kuellenberg/DP83848C-EvalBoard/STM32F407-MII-Pinout.png

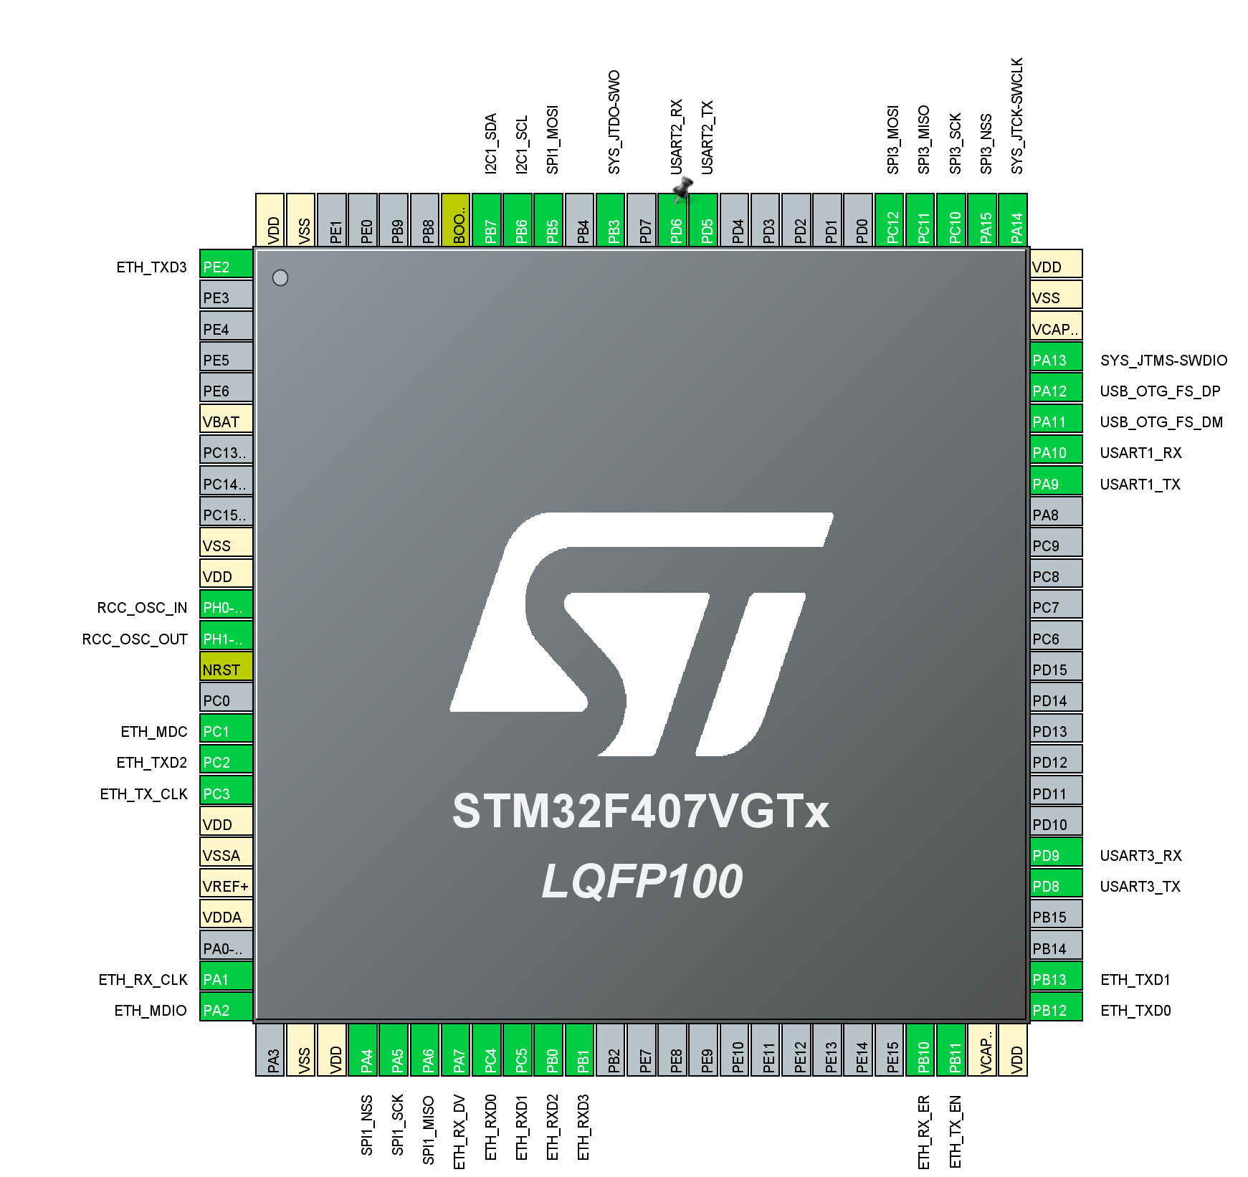
STM32F407-MII-Pinout.png
