kuellenberg/DP83848C-EvalBoard/DP83848C-EvalBoard.kicad_pcb

## KiCad design DP83848C-EvalBoard.kicad_pcb (2021-02-22)

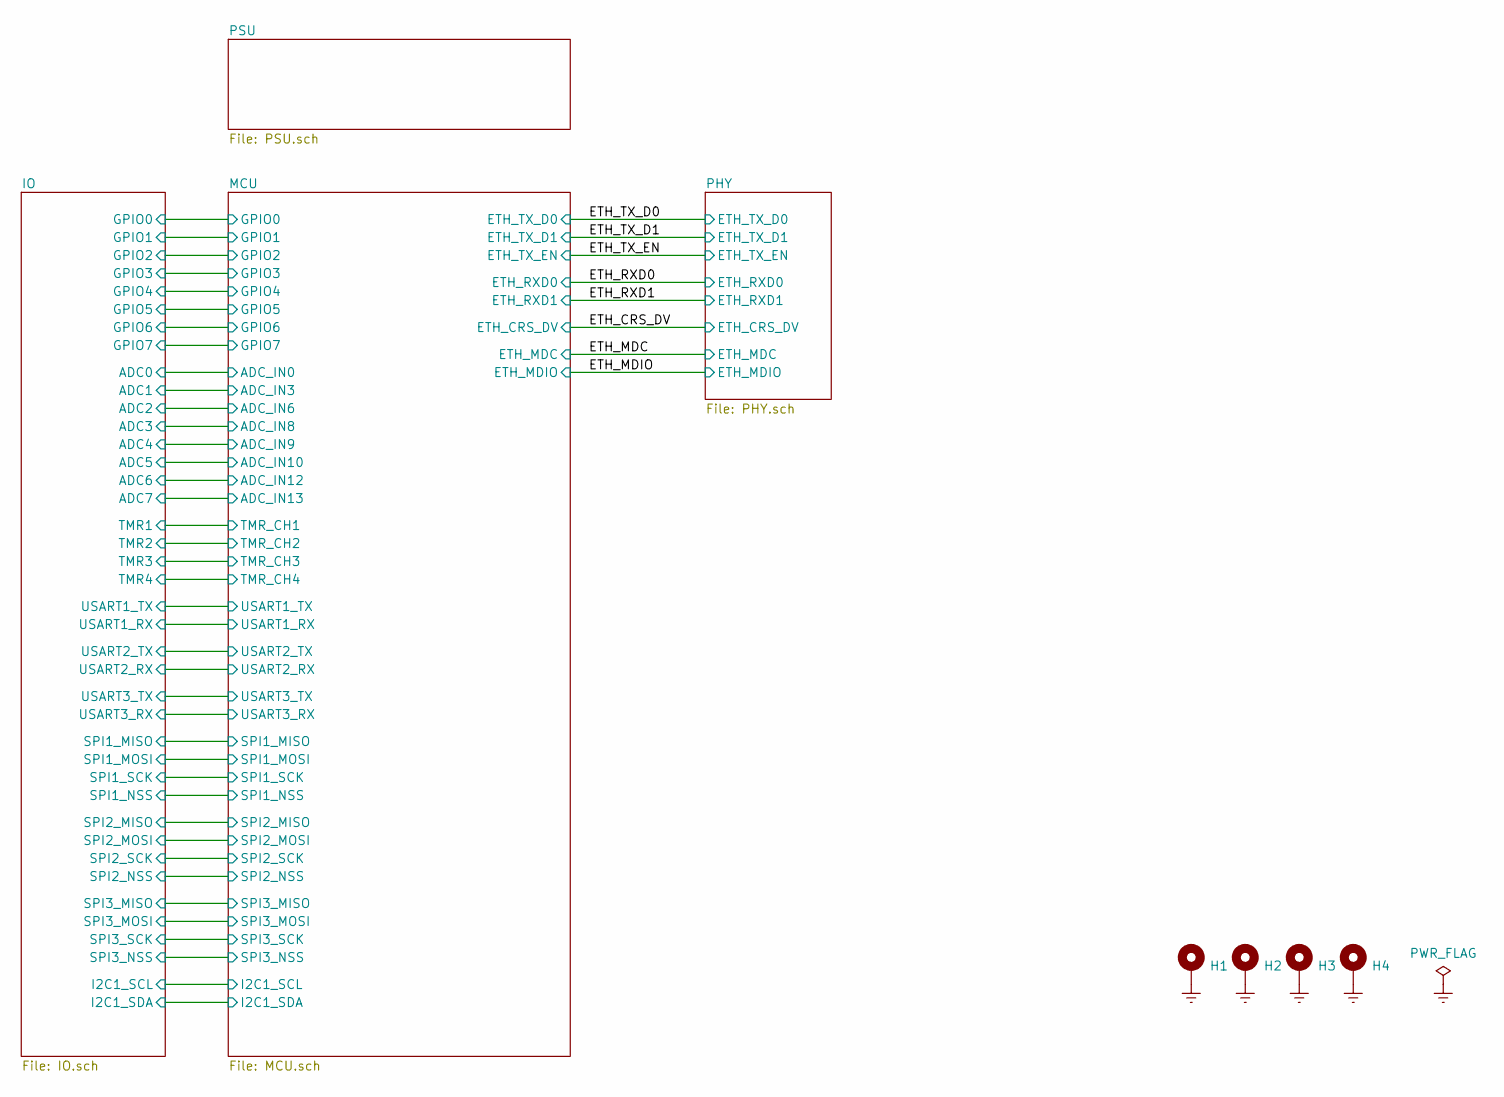
[picture p2: schematic DP83848C-EvalBoard.sch, DP83848C Eval Board]

Parts:
H1, H2, H3, H4: MountingHole_Pad; MountingHole_3.2mm_M3_Pad_Via

Connections:
Earth: H1.1, H2.1, H3.1, H4.1; also elsewhere on the board

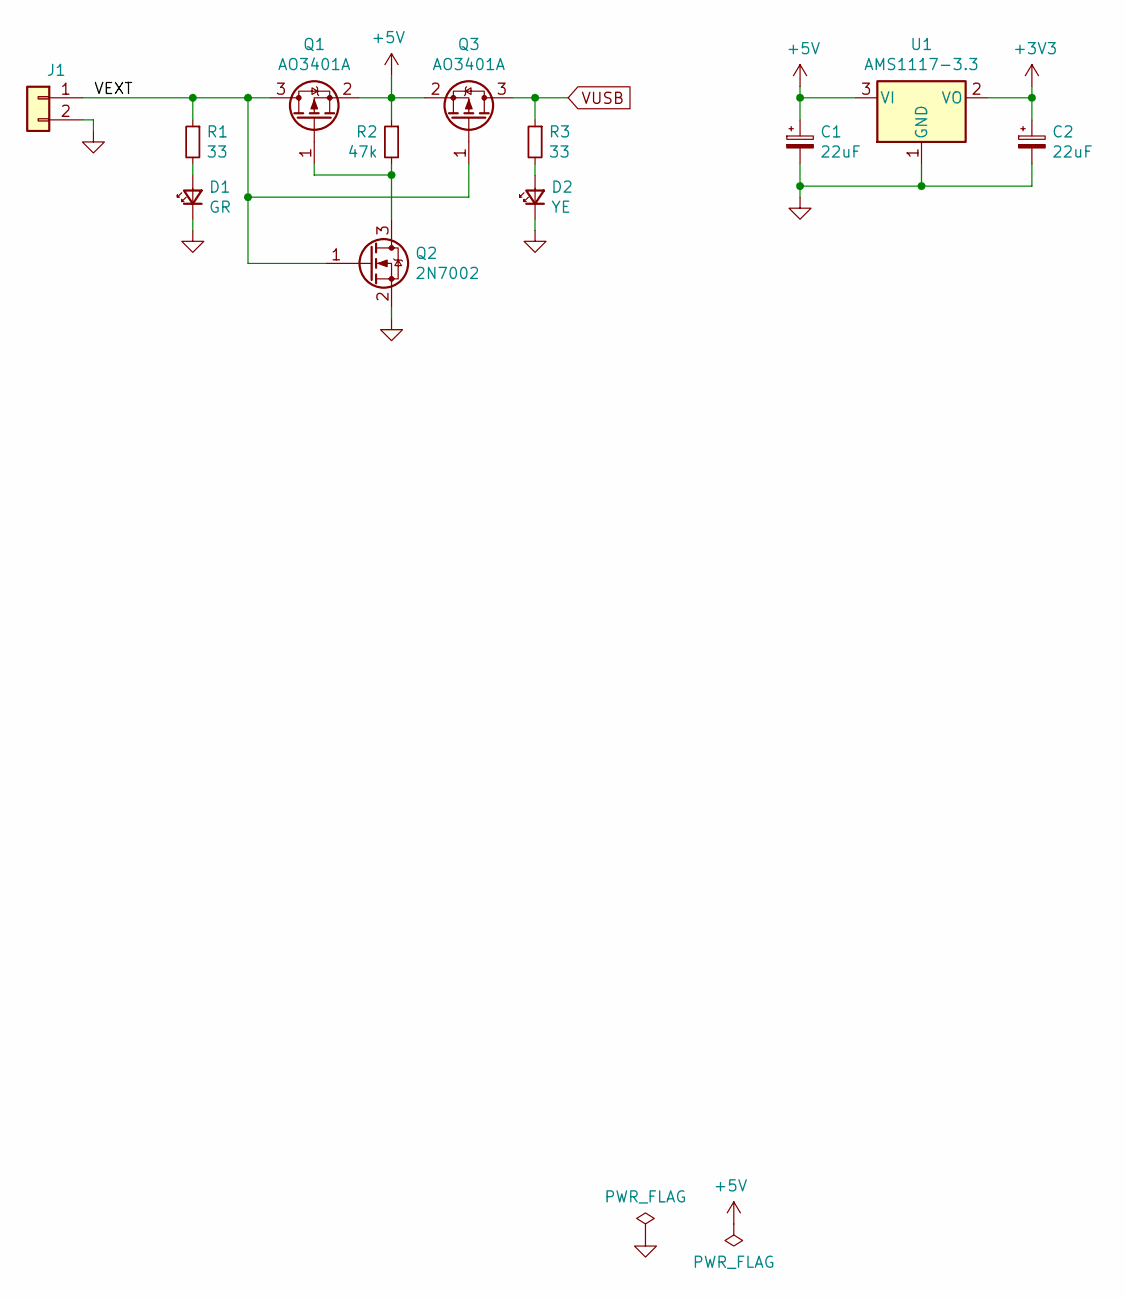
[picture p3: schematic PSU.sch]

Parts:
C1, C2: 22uF; CP_EIA-3528-15_AVX-H; LCSC C8020
D1: GR; LED_0603_1608Metric; LCSC C72043
D2: YE; LED_0603_1608Metric; LCSC C72038
J1: Conn_01x02; Molex_022112022; Mouser 538-22-11-2022
Q1, Q3: AO3401A; SOT-23; LCSC C15127
Q2: 2N7002; SOT-23; LCSC C8545
R1, R3: 33; R_0402_1005Metric; LCSC C25105
R2: 47k; R_0402_1005Metric; LCSC C25792
U1: AMS1117-3.3; SOT-223-3_TabPin2; LCSC C6186

Connections:
+3V3: C2.1, U1.2 (VO); also elsewhere on the board
+5V: C1.1, Q1.2 (S), Q3.2 (S), R2.1, U1.3 (VI)
/PSU/VEXT: J1.1, Q1.3 (D), Q2.1 (G), Q3.1 (G), R1.1
GND: C1.2, C2.2, D1.1 (K), D2.1 (K), J1.2, Q2.2 (S), U1.1 (GND); also elsewhere on the board
unnamed: D1.2 (A), R1.2
unnamed: D2.2 (A), R3.2
unnamed: Q1.1 (G), Q2.3 (D), R2.2
VUSB: Q3.3 (D), R3.1; also elsewhere on the board

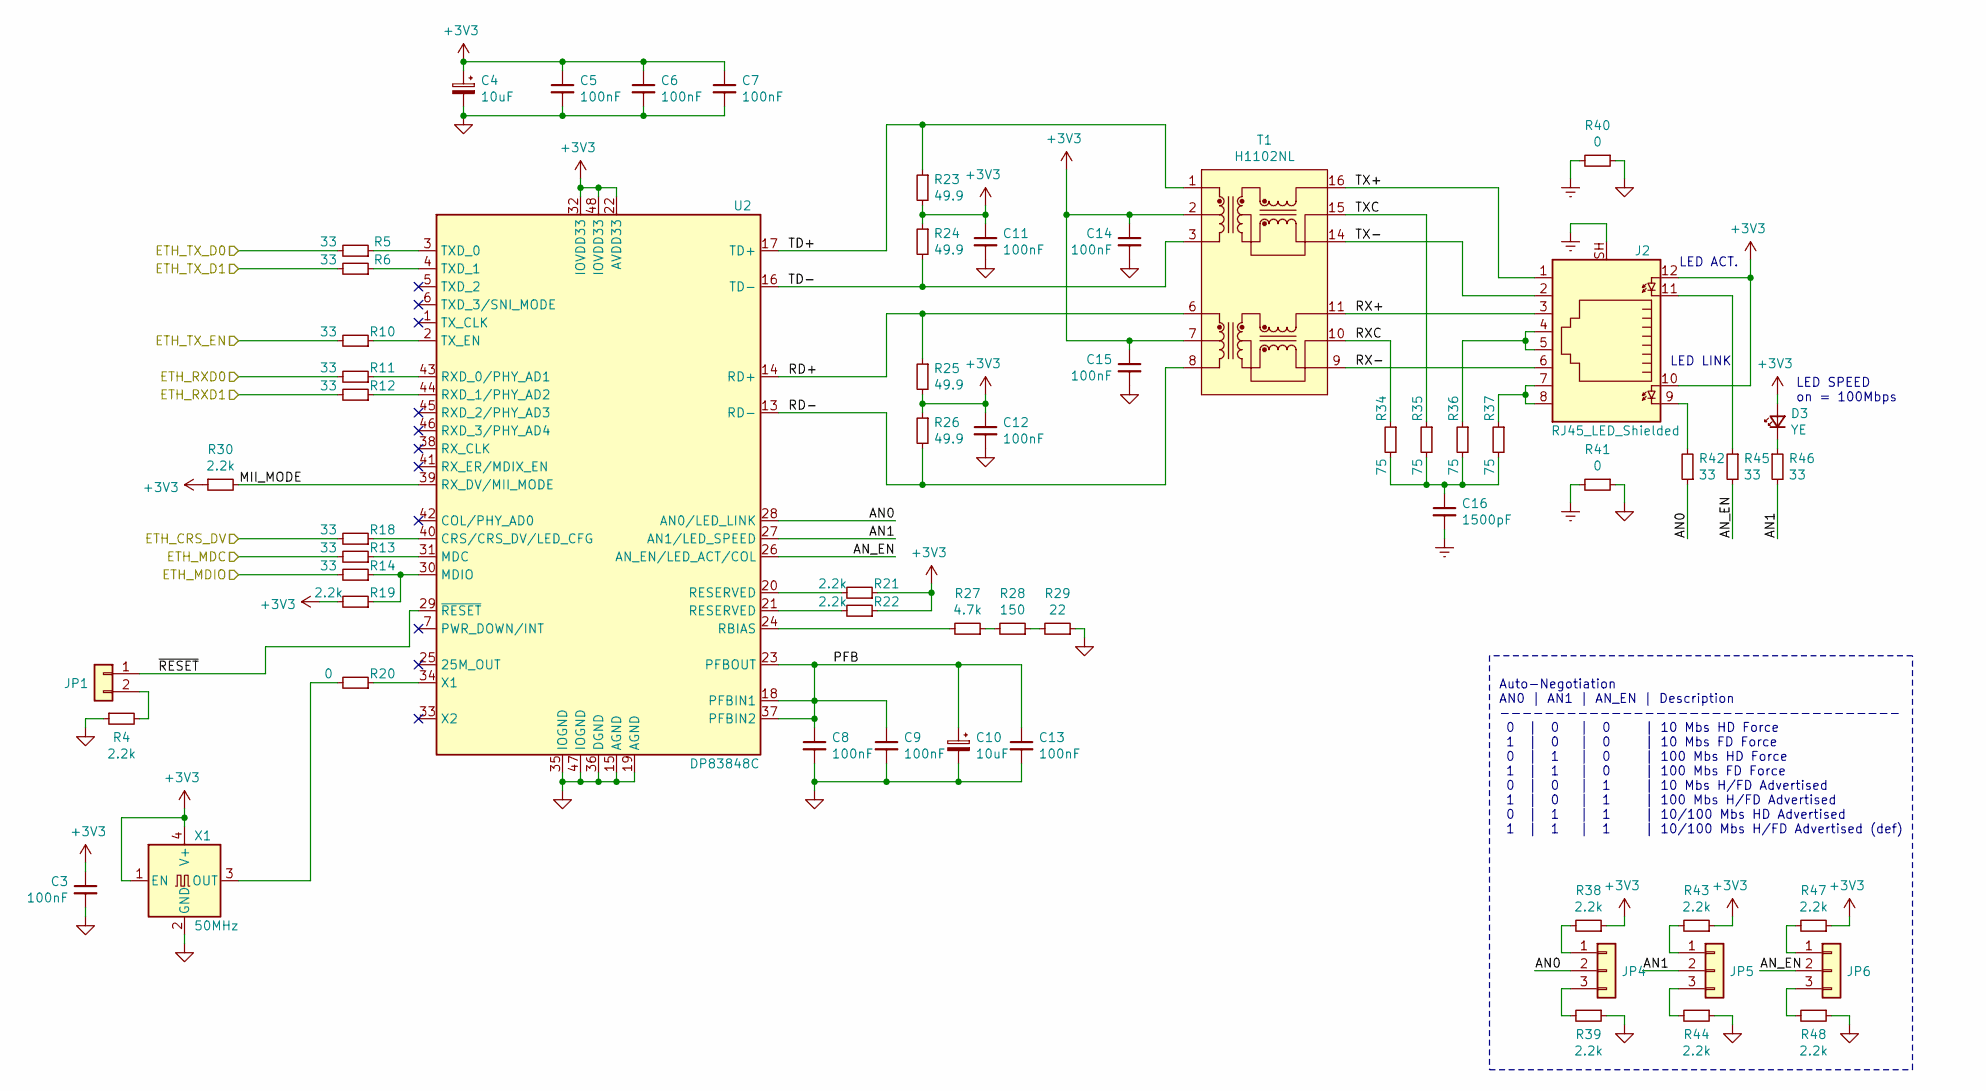
[picture p4: schematic PHY.sch, DP83848C Eval Board]

Parts:
C3, C5, C6, C7, C8, C9, C11, C12, C13, C14, C15: 100nF; C_0402_1005Metric; LCSC C1525
C4, C10: 10uF; CP_EIA-3216-18_Kemet-A; LCSC C7171
C16: 1500pF; C_0402_1005Metric; LCSC C23967
D3: YE; LED_0603_1608Metric; LCSC C72038
J2: RJ45_LED_Shielded; RJ45_Amphenol_RJHSE538X; Mouser 523-RJHSE-5381
JP1: Conn_01x02; PinHeader_1x02_P2.54mm_Vertical
JP4, JP5, JP6: Conn_01x03; PinHeader_1x03_P2.54mm_Vertical
R4, R19, R21, R22, R30, R38, R39, R43, R44, R47, R48: 2.2k; R_0402_1005Metric; LCSC C25879
R5, R6, R10, R11, R12, R13, R14, R18, R42, R45, R46: 33; R_0402_1005Metric; LCSC C25105
R20: 0; R_0402_1005Metric; LCSC C17168
R23, R24, R25, R26: 49.9; R_0402_1005Metric; LCSC C25120
R27: 4.7k; R_0402_1005Metric; LCSC C25900
R28: 150; R_0402_1005Metric; LCSC C25082
R29: 22; R_0402_1005Metric; LCSC C25092
R34, R35, R36, R37: 75; R_0402_1005Metric; LCSC C25133
R40, R41: 0; R_1206_3216Metric; LCSC C17888
T1: H1102NL; Transformer_Pulse_H1100NL; LCSC C18584
U2: DP83848C; LQFP-48_7x7mm_P0.5mm; LCSC C16688
X1: 50MHz; Oscillator_SMD_EuroQuartz_XO32-4Pin_3.2x2.5mm; LCSC C717684

Connections:
+3V3: C3.1, C4.1, C5.1, C6.1, C7.1, C11.1, C12.1, C14.1, C15.1, D3.2 (A), J2.10, J2.12, R19.2, R21.1, R22.1, R23.2, R24.1, R25.2, R26.1, R30.1, R38.1, R43.1, R47.1, T1.2, T1.7, U2.22 (AVDD33), U2.32 (IOVDD33), U2.48 (IOVDD33), X1.1 (EN), X1.4 (V+); also elsewhere on the board
/ETH_CRS_DV: R18.2; also elsewhere on the board
/ETH_MDC: R13.2; also elsewhere on the board
/ETH_MDIO: R14.2; also elsewhere on the board
/ETH_RXD0: R11.2; also elsewhere on the board
/ETH_RXD1: R12.2; also elsewhere on the board
/ETH_TX_D0: R5.2; also elsewhere on the board
/ETH_TX_D1: R6.2; also elsewhere on the board
/ETH_TX_EN: R10.2; also elsewhere on the board
/PHY/AN0: JP4.2, R42.1, U2.28 (AN0/LED_LINK)
/PHY/AN1: JP5.2, R46.2, U2.27 (AN1/LED_SPEED)
/PHY/AN_EN: JP6.2, R45.2, U2.26 (AN_EN/LED_ACT/COL)
/PHY/MII_MODE: R30.2, U2.39 (RX_DV/MII_MODE)
/PHY/PFB: C8.1, C9.1, C10.1, C13.1, U2.18 (PFBIN1), U2.23 (PFBOUT), U2.37 (PFBIN2)
/PHY/RD+: R25.1, T1.6, U2.14 (RD+)
/PHY/RD-: R26.2, T1.8, U2.13 (RD-)
/PHY/RX+: J2.3, T1.11
/PHY/RX-: J2.6, T1.9
/PHY/RXC: R34.1, T1.10
/PHY/TD+: R23.1, T1.1, U2.17 (TD+)
/PHY/TD-: R24.2, T1.3, U2.16 (TD-)
/PHY/TX+: J2.1, T1.16
/PHY/TX-: J2.2, T1.14
/PHY/TXC: R35.1, T1.15
/PHY/~RESET: JP1.1, U2.29 (~RESET~)
Earth: C16.2, J2.SH, R40.2, R41.2; also elsewhere on the board
GND: C3.2, C4.2, C5.2, C6.2, C7.2, C8.2, C9.2, C10.2, C11.2, C12.2, C13.2, C14.2, C15.2, R4.1, R29.1, R39.1, R40.1, R41.1, R44.1, R48.1, U2.15 (AGND), U2.19 (AGND), U2.35 (IOGND), U2.36 (DGND), U2.47 (IOGND), X1.2 (GND); also elsewhere on the board
unnamed: C16.1, R34.2, R35.2, R36.2, R37.2
unnamed: D3.1 (K), R46.1
unnamed: J2.4, J2.5, R36.1
unnamed: J2.7, J2.8, R37.1
unnamed: J2.9, R42.2
unnamed: J2.11, R45.1
unnamed: JP1.2, R4.2
unnamed: JP4.1, R38.2
unnamed: JP4.3, R39.2
unnamed: JP5.1, R43.2
unnamed: JP5.3, R44.2
unnamed: JP6.1, R47.2
unnamed: JP6.3, R48.2
unnamed: R5.1, U2.3 (TXD_0)
unnamed: R6.1, U2.4 (TXD_1)
unnamed: R10.1, U2.2 (TX_EN)
unnamed: R11.1, U2.43 (RXD_0/PHY_AD1)
unnamed: R12.1, U2.44 (RXD_1/PHY_AD2)
unnamed: R13.1, U2.31 (MDC)
unnamed: R14.1, R19.1, U2.30 (MDIO)
unnamed: R18.1, U2.40 (CRS/CRS_DV/LED_CFG)
unnamed: R20.1, U2.34 (X1)
unnamed: R20.2, X1.3 (OUT)
unnamed: R21.2, U2.20 (RESERVED)
unnamed: R22.2, U2.21 (RESERVED)
unnamed: R27.1, R28.2
unnamed: R27.2, U2.24 (RBIAS)
unnamed: R28.1, R29.2

Notes on the sheet:
Auto-Negotiation AN0 | AN1 | AN_EN | Description ------------------------------------ 0 | 0 | 0 | 10 Mbs HD Force 1 | 0 | 0 | 10 Mbs FD Force 0 | 1 | 0 | 100 Mbs HD Force 1 | 1 | 0 | 100 Mbs FD Force 0 | 0 | 1 | 10 Mbs H/FD Advertised 1 | 0 | 1 | 100 Mbs H/FD Advertised 0 | 1 | 1 | 10/100 Mbs HD Ad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
LED ACT.
LED LINK
LED SPEED on = 100Mbps

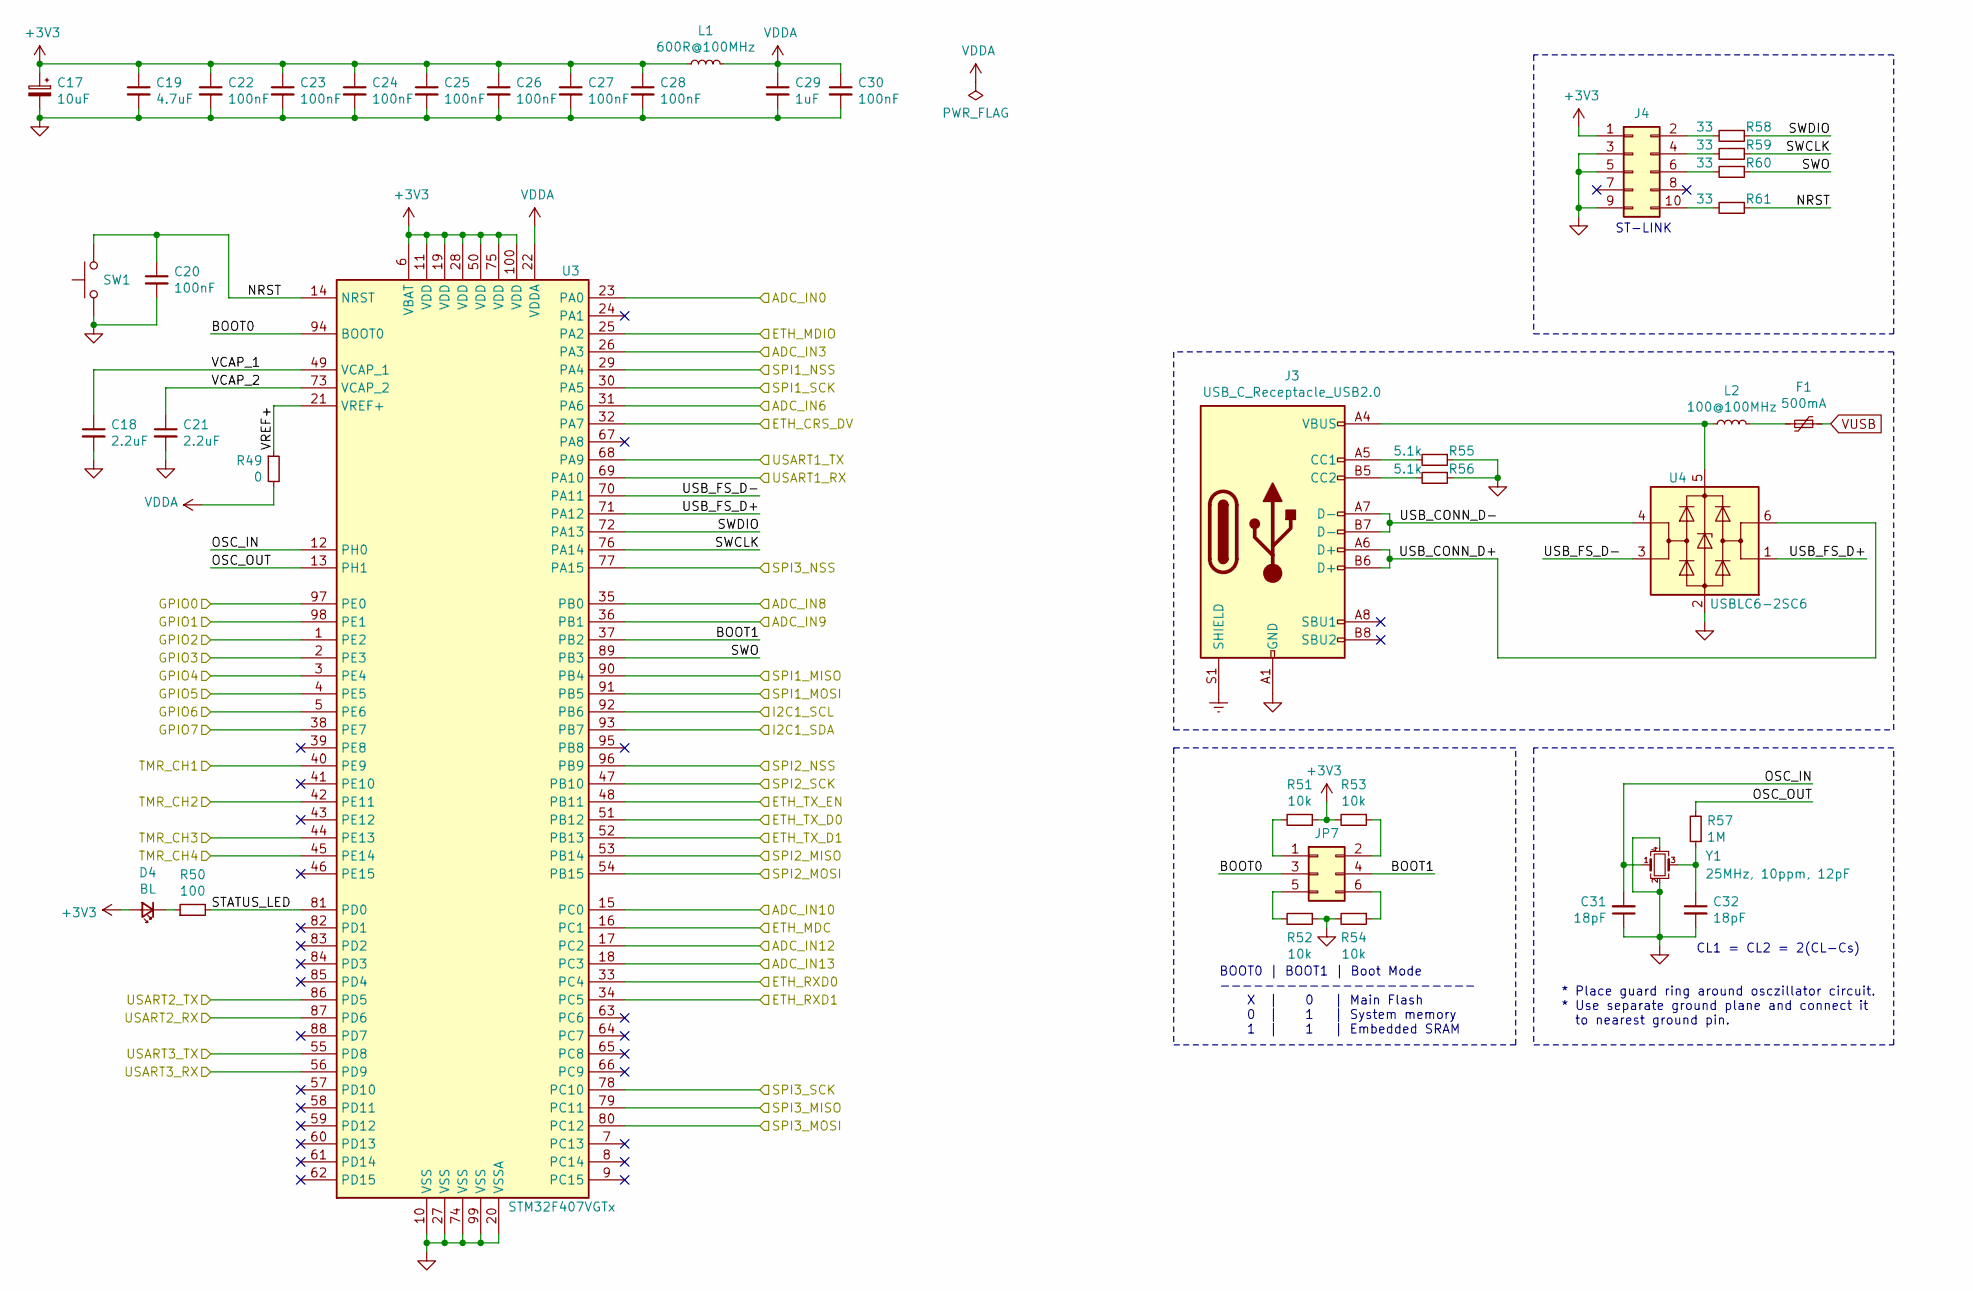
[picture p5: schematic MCU.sch]

Parts:
C17: 10uF; CP_EIA-3216-18_Kemet-A; LCSC C7171
C18, C21: 2.2uF; C_0603_1608Metric; LCSC C23630
C19: 4.7uF; C_0402_1005Metric; LCSC C23733
C20, C22, C23, C24, C25, C26, C27, C28, C30: 100nF; C_0402_1005Metric; LCSC C1525
C29: 1uF; C_0402_1005Metric; LCSC C52923
C31, C32: 18pF; C_0402_1005Metric; LCSC C1549
D4: BL; LED_0603_1608Metric; LCSC C72041
F1: 500mA; Fuse_1812_4532Metric_Castellated; Mouser 576-1812L050/60MR
J3: USB_C_Receptacle_USB2.0; DX07S016JA3R1500; Mouser 656-DX07S016JA3R1500
J4: Conn_02x05_Odd_Even; PinHeader_2x05_P2.54mm_Vertical
JP7: Conn_02x03_Odd_Even; PinHeader_2x03_P2.54mm_Vertical
L1: 600R@100MHz; L_0805_2012Metric; LCSC C1002
L2: 100@100MHz; L_0805_2012Metric; LCSC C1015
R49: 0; R_0402_1005Metric; LCSC C17168
R50: 100; R_0402_1005Metric; LCSC C25076
R51, R52, R53, R54: 10k; R_0402_1005Metric; LCSC C25744
R55, R56: 5.1k; R_0402_1005Metric; LCSC C25905
R57: 1M; R_0402_1005Metric; LCSC C26083
R58, R59, R60, R61: 33; R_0402_1005Metric; LCSC C25105
SW1: SW_Push; SW_PUSH_6mm; Mouser 611-PTS645SK432
U3: STM32F407VGTx; LQFP-100_14x14mm_P0.5mm; LCSC C28730
U4: USBLC6-2SC6; SOT-23-6; LCSC C7519
Y1: 25MHz, 10ppm, 12pF; Crystal_SMD_3225-4Pin_3.2x2.5mm; LCSC C9006

Connections:
+3V3: C17.1, C19.1, C22.1, C23.1, C24.1, C25.1, C26.1, C27.1, C28.1, D4.2 (A), J4.1, L1.1, R51.1, R53.2, U3.6 (VBAT), U3.11 (VDD), U3.19 (VDD), U3.28 (VDD), U3.50 (VDD), U3.75 (VDD), U3.100 (VDD); also elsewhere on the board
/ETH_CRS_DV: U3.32 (PA7); also elsewhere on the board
/ETH_MDC: U3.16 (PC1); also elsewhere on the board
/ETH_MDIO: U3.25 (PA2); also elsewhere on the board
/ETH_RXD0: U3.33 (PC4); also elsewhere on the board
/ETH_RXD1: U3.34 (PC5); also elsewhere on the board
/ETH_TX_D0: U3.51 (PB12); also elsewhere on the board
/ETH_TX_D1: U3.52 (PB13); also elsewhere on the board
/ETH_TX_EN: U3.48 (PB11); also elsewhere on the board
/IO/ADC0: U3.23 (PA0); also elsewhere on the board
/IO/ADC1: U3.26 (PA3); also elsewhere on the board
/IO/ADC2: U3.31 (PA6); also elsewhere on the board
/IO/ADC3: U3.35 (PB0); also elsewhere on the board
/IO/ADC4: U3.36 (PB1); also elsewhere on the board
/IO/ADC5: U3.15 (PC0); also elsewhere on the board
/IO/ADC6: U3.17 (PC2); also elsewhere on the board
/IO/ADC7: U3.18 (PC3); also elsewhere on the board
/IO/GPIO0: U3.97 (PE0); also elsewhere on the board
/IO/GPIO1: U3.98 (PE1); also elsewhere on the board
/IO/GPIO2: U3.1 (PE2); also elsewhere on the board
/IO/GPIO3: U3.2 (PE3); also elsewhere on the board
/IO/GPIO4: U3.3 (PE4); also elsewhere on the board
/IO/GPIO5: U3.4 (PE5); also elsewhere on the board
/IO/GPIO6: U3.5 (PE6); also elsewhere on the board
/IO/GPIO7: U3.38 (PE7); also elsewhere on the board
/IO/I2C1_SCL: U3.92 (PB6); also elsewhere on the board
/IO/I2C1_SDA: U3.93 (PB7); also elsewhere on the board
/IO/SPI1_MISO: U3.90 (PB4); also elsewhere on the board
/IO/SPI1_MOSI: U3.91 (PB5); also elsewhere on the board
/IO/SPI1_NSS: U3.29 (PA4); also elsewhere on the board
/IO/SPI1_SCK: U3.30 (PA5); also elsewhere on the board
/IO/SPI2_MISO: U3.53 (PB14); also elsewhere on the board
/IO/SPI2_MOSI: U3.54 (PB15); also elsewhere on the board
/IO/SPI2_NSS: U3.96 (PB9); also elsewhere on the board
/IO/SPI2_SCK: U3.47 (PB10); also elsewhere on the board
/IO/SPI3_MISO: U3.79 (PC11); also elsewhere on the board
/IO/SPI3_MOSI: U3.80 (PC12); also elsewhere on the board
/IO/SPI3_NSS: U3.77 (PA15); also elsewhere on the board
/IO/SPI3_SCK: U3.78 (PC10); also elsewhere on the board
/IO/TMR1: U3.40 (PE9); also elsewhere on the board
/IO/TMR2: U3.42 (PE11); also elsewhere on the board
/IO/TMR3: U3.44 (PE13); also elsewhere on the board
/IO/TMR4: U3.45 (PE14); also elsewhere on the board
/IO/USART1_RX: U3.69 (PA10); also elsewhere on the board
/IO/USART1_TX: U3.68 (PA9); also elsewhere on the board
/IO/USART2_RX: U3.87 (PD6); also elsewhere on the board
/IO/USART2_TX: U3.86 (PD5); also elsewhere on the board
/IO/USART3_RX: U3.56 (PD9); also elsewhere on the board
/IO/USART3_TX: U3.55 (PD8); also elsewhere on the board
/MCU/BOOT0: JP7.3, U3.94 (BOOT0)
/MCU/BOOT1: JP7.4, U3.37 (PB2)
/MCU/NRST: C20.1, R61.1, SW1.1, U3.14 (NRST)
/MCU/OSC_IN: C31.2, U3.12 (PH0), Y1.1
/MCU/OSC_OUT: R57.2, U3.13 (PH1)
/MCU/STATUS_LED: R50.2, U3.81 (PD0)
/MCU/SWCLK: R59.1, U3.76 (PA14)
/MCU/SWDIO: R58.1, U3.72 (PA13)
/MCU/SWO: R60.1, U3.89 (PB3)
/MCU/USB_CONN_D+: J3.A6 (D+), J3.B6 (D+), U4.6 (I/O1)
/MCU/USB_CONN_D-: J3.A7 (D-), J3.B7 (D-), U4.4 (I/O2)
/MCU/USB_FS_D+: U3.71 (PA12), U4.1 (I/O1)
/MCU/USB_FS_D-: U3.70 (PA11), U4.3 (I/O2)
/MCU/VCAP_1: C18.1, U3.49 (VCAP_1)
/MCU/VCAP_2: C21.1, U3.73 (VCAP_2)
/MCU/VREF+: R49.1, U3.21 (VREF+)
Earth: J3.S1 (SHIELD); also elsewhere on the board
GND: C17.2, C18.2, C19.2, C20.2, C21.2, C22.2, C23.2, C24.2, C25.2, C26.2, C27.2, C28.2, C29.2, C30.2, C31.1, C32.2, J3.A1 (GND), J3.A12 (GND), J3.B1 (GND), J3.B12 (GND), J4.3, J4.5, J4.9, R52.1, R54.2, R55.1, R56.1, SW1.2, U3.10 (VSS), U3.20 (VSSA), U3.27 (VSS), U3.74 (VSS), U3.99 (VSS), U4.2 (GND), Y1.2, Y1.4; also elsewhere on the board
unnamed: C32.1, R57.1, Y1.3
unnamed: D4.1 (K), R50.1
unnamed: F1.2, L2.2
unnamed: J3.A4 (VBUS), J3.A9 (VBUS), J3.B4 (VBUS), J3.B9 (VBUS), L2.1, U4.5 (VBUS)
unnamed: J3.A5 (CC1), R55.2
unnamed: J3.B5 (CC2), R56.2
unnamed: J4.2, R58.2
unnamed: J4.4, R59.2
unnamed: J4.6, R60.2
unnamed: J4.10, R61.2
unnamed: JP7.1, R51.2
unnamed: JP7.2, R53.1
unnamed: JP7.5, R52.2
unnamed: JP7.6, R54.1
VDDA: C29.1, C30.1, L1.2, R49.2, U3.22 (VDDA)
VUSB: F1.1; also elsewhere on the board

Notes on the sheet:
BOOT0 | BOOT1 | Boot Mode ----------------------- X | 0 | Main Flash 0 | 1 | System memory 1 | 1 | Embedded SRAM
ST-LINK
* Place guard ring around osczillator circuit. * Use separate ground plane and connect it to nearest ground pin.
CL1 = CL2 = 2(CL-Cs)

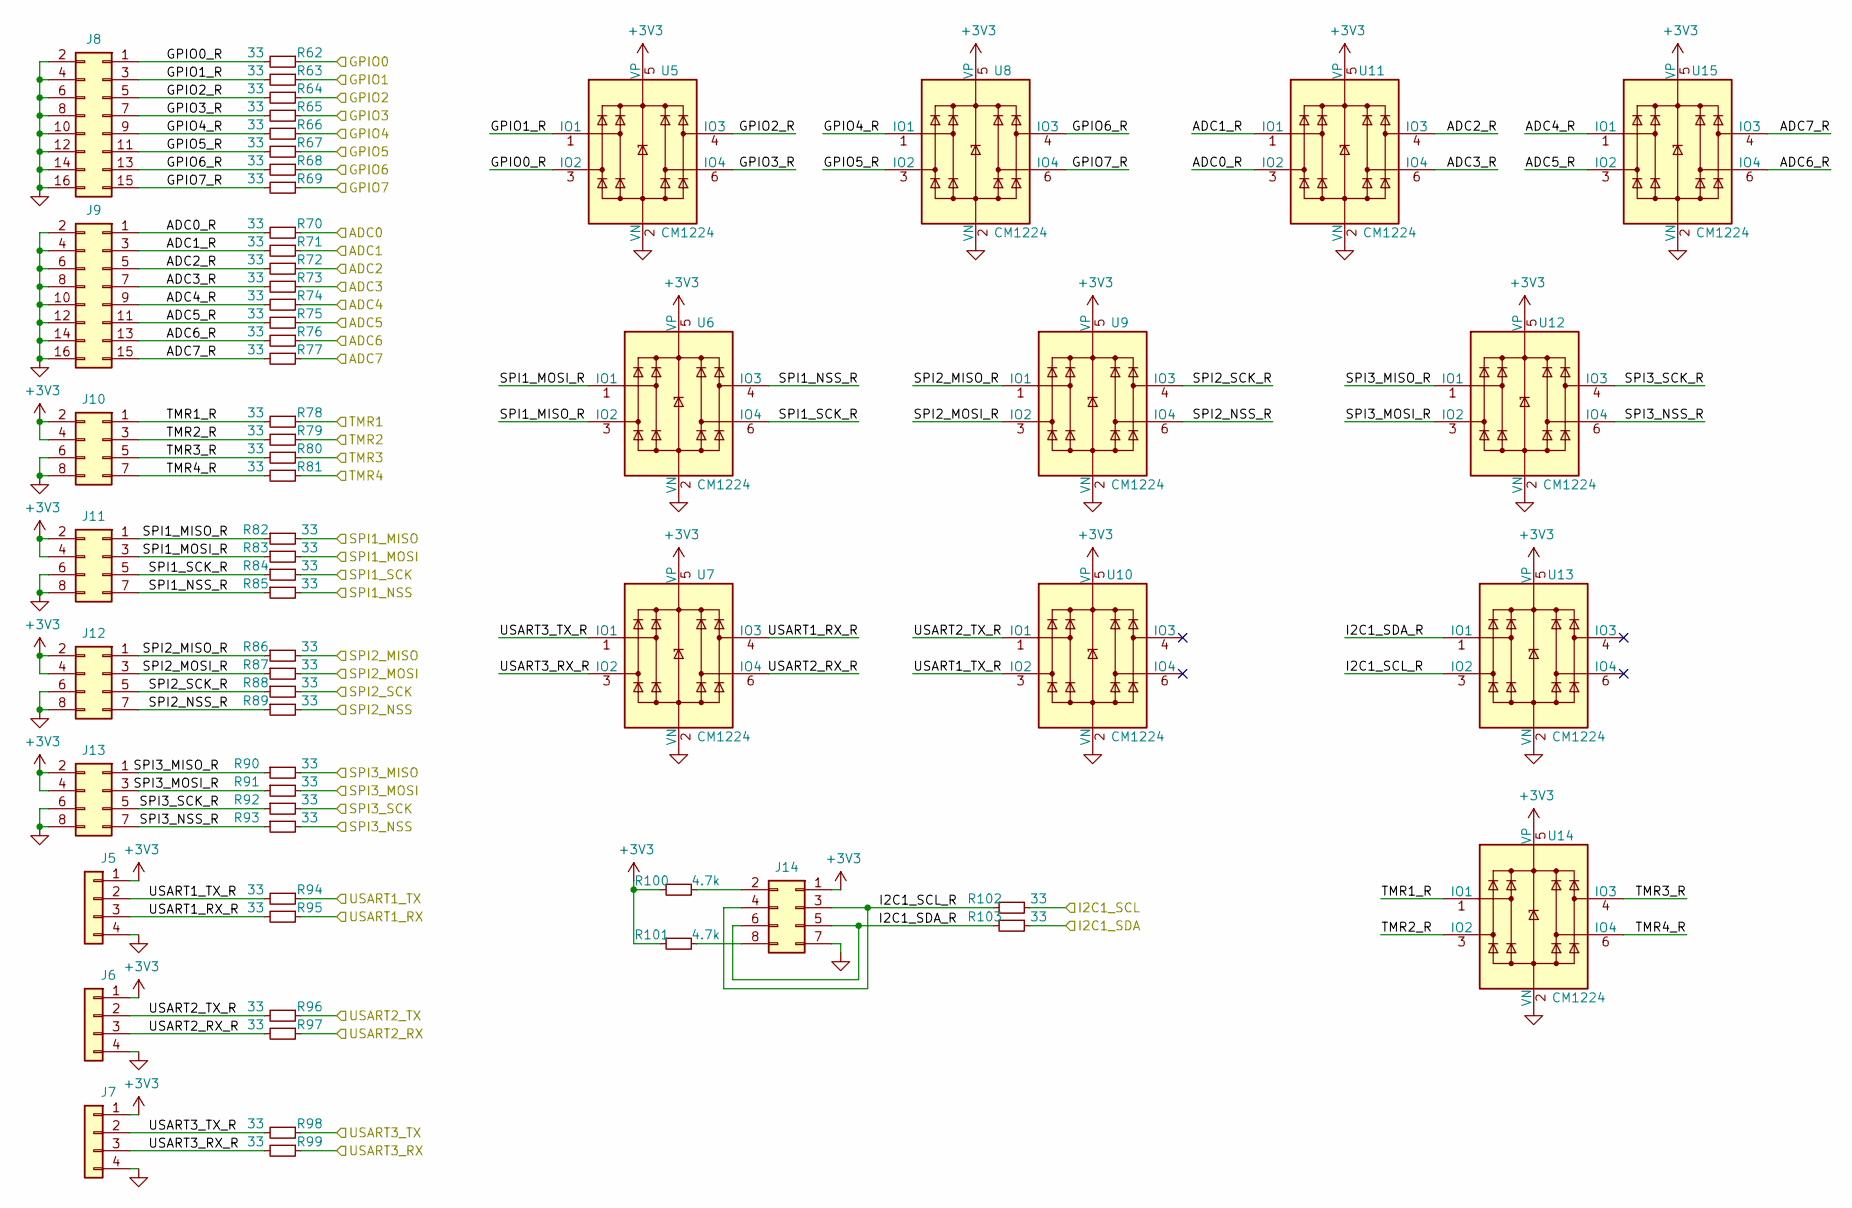
[picture p6: schematic IO.sch]

Parts:
J5, J6, J7: Conn_01x04; PinHeader_1x04_P2.54mm_Vertical
J8, J9: Conn_02x08_Odd_Even; PinHeader_2x08_P2.54mm_Vertical
J10, J11, J12, J13, J14: Conn_02x04_Odd_Even; PinHeader_2x04_P2.54mm_Vertical
R62, R63, R64, R65, R66, R67, R68, R69, R70, R71, R72, R73, R74, R75, R76, R77, R78, R79, R80, R81, R82, R83, R84, R85, R86, R87, R88, R89, R90, R91, R92, R93, R94, R95, R96, R97, R98, R99, R102, R103: 33; R_0402_1005Metric; LCSC C25105
R100, R101: 4.7k; R_0402_1005Metric; LCSC C25900
U5, U6, U7, U8, U9, U10, U11, U12, U13, U14, U15: CM1224; SOT-23-6; LCSC C233379

Connections:
+3V3: J5.1, J6.1, J7.1, J10.2, J10.4, J11.2, J11.4, J12.2, J12.4, J13.2, J13.4, J14.1, R100.1, R101.1, U5.5 (VP), U6.5 (VP), U7.5 (VP), U8.5 (VP), U9.5 (VP), U10.5 (VP), U11.5 (VP), U12.5 (VP), U13.5 (VP), U14.5 (VP), U15.5 (VP); also elsewhere on the board
/IO/ADC0: R70.1; also elsewhere on the board
/IO/ADC0_R: J9.1, R70.2, U11.3 (IO2)
/IO/ADC1: R71.1; also elsewhere on the board
/IO/ADC1_R: J9.3, R71.2, U11.1 (IO1)
/IO/ADC2: R72.1; also elsewhere on the board
/IO/ADC2_R: J9.5, R72.2, U11.4 (IO3)
/IO/ADC3: R73.1; also elsewhere on the board
/IO/ADC3_R: J9.7, R73.2, U11.6 (IO4)
/IO/ADC4: R74.1; also elsewhere on the board
/IO/ADC4_R: J9.9, R74.2, U15.1 (IO1)
/IO/ADC5: R75.1; also elsewhere on the board
/IO/ADC5_R: J9.11, R75.2, U15.3 (IO2)
/IO/ADC6: R76.1; also elsewhere on the board
/IO/ADC6_R: J9.13, R76.2, U15.6 (IO4)
/IO/ADC7: R77.1; also elsewhere on the board
/IO/ADC7_R: J9.15, R77.2, U15.4 (IO3)
/IO/GPIO0: R62.1; also elsewhere on the board
/IO/GPIO0_R: J8.1, R62.2, U5.3 (IO2)
/IO/GPIO1: R63.1; also elsewhere on the board
/IO/GPIO1_R: J8.3, R63.2, U5.1 (IO1)
/IO/GPIO2: R64.1; also elsewhere on the board
/IO/GPIO2_R: J8.5, R64.2, U5.4 (IO3)
/IO/GPIO3: R65.1; also elsewhere on the board
/IO/GPIO3_R: J8.7, R65.2, U5.6 (IO4)
/IO/GPIO4: R66.1; also elsewhere on the board
/IO/GPIO4_R: J8.9, R66.2, U8.1 (IO1)
/IO/GPIO5: R67.1; also elsewhere on the board
/IO/GPIO5_R: J8.11, R67.2, U8.3 (IO2)
/IO/GPIO6: R68.1; also elsewhere on the board
/IO/GPIO6_R: J8.13, R68.2, U8.4 (IO3)
/IO/GPIO7: R69.1; also elsewhere on the board
/IO/GPIO7_R: J8.15, R69.2, U8.6 (IO4)
/IO/I2C1_SCL: R102.2; also elsewhere on the board
/IO/I2C1_SCL_R: J14.3, J14.4, R102.1, U13.3 (IO2)
/IO/I2C1_SDA: R103.2; also elsewhere on the board
/IO/I2C1_SDA_R: J14.5, J14.6, R103.1, U13.1 (IO1)
/IO/SPI1_MISO: R82.2; also elsewhere on the board
/IO/SPI1_MISO_R: J11.1, R82.1, U6.3 (IO2)
/IO/SPI1_MOSI: R83.2; also elsewhere on the board
/IO/SPI1_MOSI_R: J11.3, R83.1, U6.1 (IO1)
/IO/SPI1_NSS: R85.2; also elsewhere on the board
/IO/SPI1_NSS_R: J11.7, R85.1, U6.4 (IO3)
/IO/SPI1_SCK: R84.2; also elsewhere on the board
/IO/SPI1_SCK_R: J11.5, R84.1, U6.6 (IO4)
/IO/SPI2_MISO: R86.2; also elsewhere on the board
/IO/SPI2_MISO_R: J12.1, R86.1, U9.1 (IO1)
/IO/SPI2_MOSI: R87.2; also elsewhere on the board
/IO/SPI2_MOSI_R: J12.3, R87.1, U9.3 (IO2)
/IO/SPI2_NSS: R89.2; also elsewhere on the board
/IO/SPI2_NSS_R: J12.7, R89.1, U9.6 (IO4)
/IO/SPI2_SCK: R88.2; also elsewhere on the board
/IO/SPI2_SCK_R: J12.5, R88.1, U9.4 (IO3)
/IO/SPI3_MISO: R90.2; also elsewhere on the board
/IO/SPI3_MISO_R: J13.1, R90.1, U12.1 (IO1)
/IO/SPI3_MOSI: R91.2; also elsewhere on the board
/IO/SPI3_MOSI_R: J13.3, R91.1, U12.3 (IO2)
/IO/SPI3_NSS: R93.2; also elsewhere on the board
/IO/SPI3_NSS_R: J13.7, R93.1, U12.6 (IO4)
/IO/SPI3_SCK: R92.2; also elsewhere on the board
/IO/SPI3_SCK_R: J13.5, R92.1, U12.4 (IO3)
/IO/TMR1: R78.1; also elsewhere on the board
/IO/TMR1_R: J10.1, R78.2, U14.1 (IO1)
/IO/TMR2: R79.1; also elsewhere on the board
/IO/TMR2_R: J10.3, R79.2, U14.3 (IO2)
/IO/TMR3: R80.1; also elsewhere on the board
/IO/TMR3_R: J10.5, R80.2, U14.4 (IO3)
/IO/TMR4: R81.1; also elsewhere on the board
/IO/TMR4_R: J10.7, R81.2, U14.6 (IO4)
/IO/USART1_RX: R95.1; also elsewhere on the board
/IO/USART1_RX_R: J5.3, R95.2, U7.4 (IO3)
/IO/USART1_TX: R94.1; also elsewhere on the board
/IO/USART1_TX_R: J5.2, R94.2, U10.3 (IO2)
/IO/USART2_RX: R97.1; also elsewhere on the board
/IO/USART2_RX_R: J6.3, R97.2, U7.6 (IO4)
/IO/USART2_TX: R96.1; also elsewhere on the board
/IO/USART2_TX_R: J6.2, R96.2, U10.1 (IO1)
/IO/USART3_RX: R99.1; also elsewhere on the board
/IO/USART3_RX_R: J7.3, R99.2, U7.3 (IO2)
/IO/USART3_TX: R98.1; also elsewhere on the board
/IO/USART3_TX_R: J7.2, R98.2, U7.1 (IO1)
GND: J5.4, J6.4, J7.4, J8.2, J8.4, J8.6, J8.8, J8.10, J8.12, J8.14, J8.16, J9.2, J9.4, J9.6, J9.8, J9.10, J9.12, J9.14, J9.16, J10.6, J10.8, J11.6, J11.8, J12.6, J12.8, J13.6, J13.8, J14.7, U5.2 (VN), U6.2 (VN), U7.2 (VN), U8.2 (VN), U9.2 (VN), U10.2 (VN), U11.2 (VN), U12.2 (VN), U13.2 (VN), U14.2 (VN), U15.2 (VN); also elsewhere on the board
unnamed: J14.2, R100.2
unnamed: J14.8, R101.2

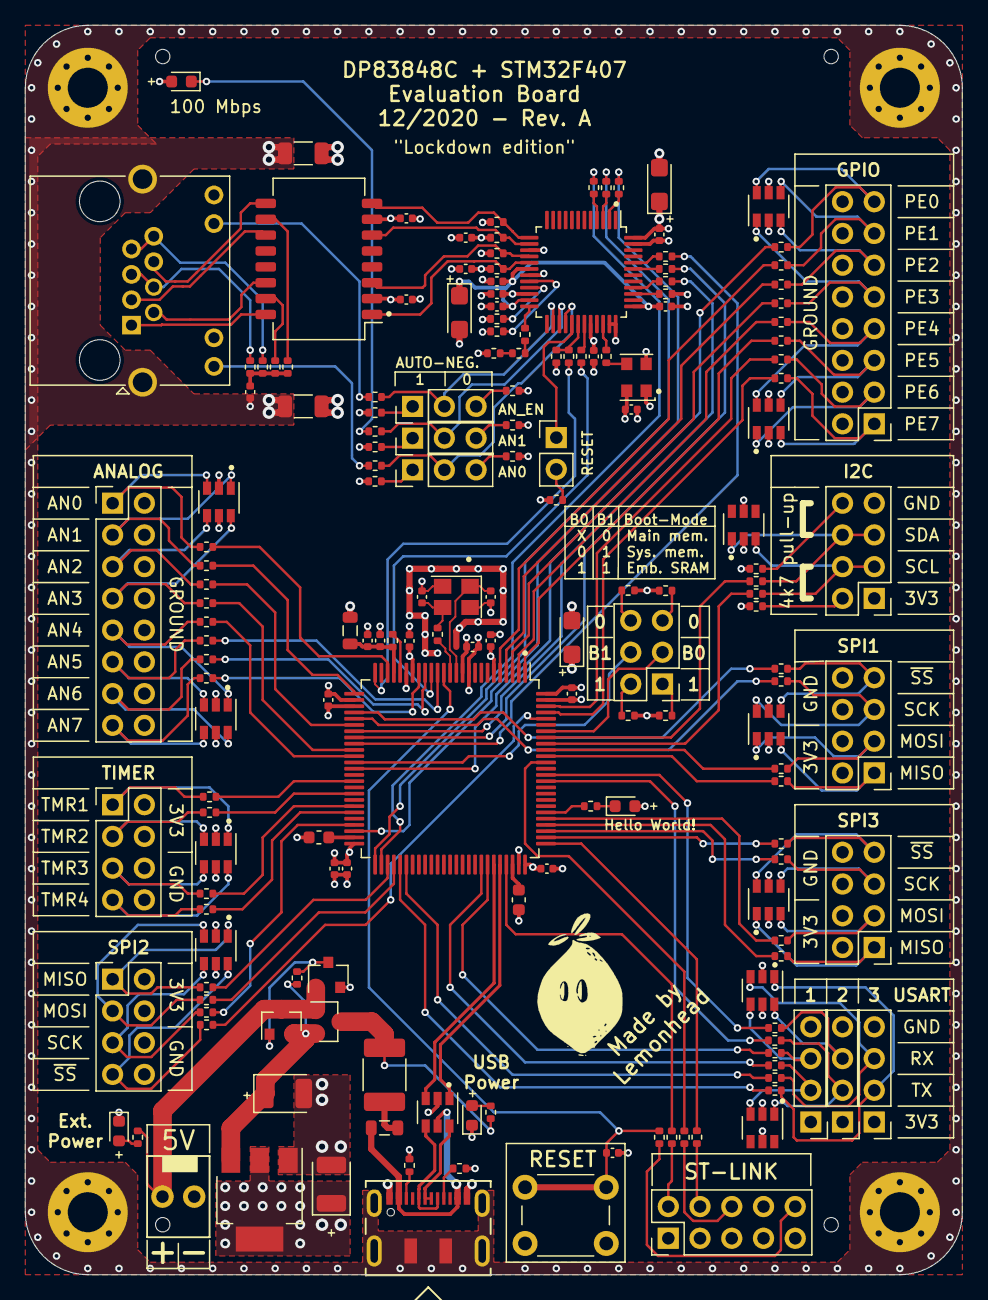
[picture p7: board DP83848C-EvalBoard.kicad_pcb from above]

Board: 4 copper layers, 75.0 x 100.0 mm, 178 parts (0 on the bottom side), 174 nets.
