kuellenberg/DP83848C-EvalBoard/Firmware-DP83848C-Evalboard/Core/Src/main.c

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
/* Includes ------------------------------------------------------------------*/
#include "main.h"
#include "lwip.h"
#include "usb_device.h"

/* USER CODE BEGIN Includes */
#include "lwip/apps/mqtt.h"
#include "usbd_cdc_if.h"

/* USER CODE END Includes */

TIM_HandleTypeDef htim3;

/* USER CODE BEGIN PV */


mqtt_client_t *client;
char txBuf[100];


/* USER CODE END PV */

void SystemClock_Config(void);
static void MX_GPIO_Init(void);
static void MX_TIM3_Init(void);
/* USER CODE BEGIN 0 */

static int inpub_id;

static void mqtt_incoming_data_cb(void *arg, const u8_t *data, u16_t len, u8_t flags)
{
  sprintf(txBuf, "Incoming publish payload with length %d, flags %u\n", len, (unsigned int)flags);
  CDC_Transmit_FS(txBuf, strlen(txBuf));

  if(flags & MQTT_DATA_FLAG_LAST) {
    /* Last fragment of payload received (or whole part if payload fits receive buffer
       See MQTT_VAR_HEADER_BUFFER_LEN)  */

    /* Call function or do action depending on reference, in this case inpub_id */
    if(inpub_id == 0) {
      /* Don't trust the publisher, check zero termination */
      if(data[len-1] == 0) {
        sprintf(txBuf, "mqtt_incoming_data_cb: %s\n", (const char *)data);
        CDC_Transmit_FS(txBuf, strlen(txBuf));
      }
    } else if(inpub_id == 1) {
      /* Call an 'A' function... */
    } else {
      sprintf(txBuf, "mqtt_incoming_data_cb: Ignoring payload...\n");
      CDC_Transmit_FS(txBuf, strlen(txBuf));
    }
  } else {
    /* Handle fragmented payload, store in buffer, write to file or whatever */
  }
}

static void mqtt_incoming_publish_cb(void *arg, const char *topic, u32_t tot_len)
{
  sprintf(txBuf, "Incoming publish at topic %s with total length %u\n", topic, (unsigned int)tot_len);
  CDC_Transmit_FS(txBuf, strlen(txBuf));

  /* Decode topic string into a user defined reference */
  if(strcmp(topic, "test") == 0) {
    inpub_id = 0;
  } else if(topic[0] == 'A') {
    /* All topics starting with 'A' might be handled at the same way */
    inpub_id = 1;
  } else {
    /* For all other topics */
    inpub_id = 2;
  }
}

static void mqtt_sub_request_cb(void *arg, err_t result)
{
  /* Just print the result code here for simplicity,
     normal behaviour would be to take some action if subscribe fails like
     notifying user, retry subscribe or disconnect from server */
  sprintf(txBuf, "Subscribe result: %d\n", result);
  CDC_Transmit_FS(txBuf, strlen(txBuf));
}

static void mqtt_connection_cb(mqtt_client_t *client, void *arg, mqtt_connection_status_t status)
{
  err_t err;
  if(status == MQTT_CONNECT_ACCEPTED) {
    sprintf(txBuf, "mqtt_connection_cb: Successfully connected\n");
	CDC_Transmit_FS(txBuf, strlen(txBuf));

    /* Setup callback for incoming publish requests */
    mqtt_set_inpub_callback(client, mqtt_incoming_publish_cb, mqtt_incoming_data_cb, arg);

    /* Subscribe to a topic named "subtopic" with QoS level 1, call mqtt_sub_request_cb with result */
    err = mqtt_subscribe(client, "moo", 1, mqtt_sub_request_cb, arg);

    if(err != ERR_OK) {
      sprintf(txBuf, "mqtt_subscribe return: %d\n", err);
      CDC_Transmit_FS(txBuf, strlen(txBuf));
    }
  } else {
    sprintf(txBuf, "mqtt_connection_cb: Disconnected, reason: %d\n", status);
	CDC_Transmit_FS(txBuf, strlen(txBuf));

    /* Its more nice to be connected, so try to reconnect */
    example_do_connect(client);
  }
}


void example_do_connect(mqtt_client_t *client)
{
  struct mqtt_connect_client_info_t ci;
  err_t err;
  ip_addr_t broker;
  IP4_ADDR(&broker ,192,168,0,21);

  /* Setup an empty client info structure */
  memset(&ci, 0, sizeof(ci));

  /* Minimal amount of information required is client identifier, so set it here */
  ci.client_id = "lwip_test";

  /* Initiate client and connect to server, if this fails immediately an error code is returned
     otherwise mqtt_connection_cb will be called with connection result after attempting
     to establish a connection with the server.
     For now MQTT version 3.1.1 is always used */

  err = mqtt_client_connect(client, &broker, 1883, mqtt_connection_cb, 0, &ci);

  /* For now just print the result code if something goes wrong */
  if(err != ERR_OK) {
    sprintf(txBuf, "mqtt_connect return %d\n", err);
	CDC_Transmit_FS(txBuf, strlen(txBuf));
  }
}


/* Called when publish is complete either with sucess or failure */
static void mqtt_pub_request_cb(void *arg, err_t result)
{
  if(result != ERR_OK) {
    sprintf(txBuf, "Publish result: %d\n", result);
    CDC_Transmit_FS(txBuf, strlen(txBuf));
  }
}




void example_publish(mqtt_client_t *client, void *arg)
{
  const char *pub_payload= "Moobert sagt moo!";
  err_t err;
  u8_t qos = 2; /* 0 1 or 2, see MQTT specification */
  u8_t retain = 0; /* No don't retain such crappy payload... */
  err = mqtt_publish(client, "test", pub_payload, strlen(pub_payload), qos, retain, mqtt_pub_request_cb, arg);
  if(err != ERR_OK) {
    printf("Publish err: %d\n", err);
  }
}

void HAL_TIM_PeriodElapsedCallback(TIM_HandleTypeDef *htim)
{
	if (htim->Instance==TIM3) {
		HAL_GPIO_TogglePin(LED_GPIO_Port, LED_Pin);
		example_do_connect(client);
		example_publish(client, NULL);
	}
}



/* USER CODE END 0 */

/**
  * @brief  The application entry point.
  * @retval int
  */
int main(void)
{
  /* MCU Configuration--------------------------------------------------------*/

  /* Reset of all peripherals, Initializes the Flash interface and the Systick. */
  HAL_Init();

  /* Configure the system clock */
  SystemClock_Config();

  /* Initialize all configured peripherals */
  MX_GPIO_Init();
  MX_LWIP_Init();
  MX_TIM3_Init();
  MX_USB_DEVICE_Init();
  /* USER CODE BEGIN 2 */

  HAL_TIM_Base_Start_IT(&htim3);

  client = mqtt_client_new();
  example_do_connect(client);

  /* USER CODE END 2 */

  /* Infinite loop */
  /* USER CODE BEGIN WHILE */
  while (1)
  {
    /* USER CODE END WHILE */

    /* USER CODE BEGIN 3 */

	  MX_LWIP_Process();

  }
  /* USER CODE END 3 */
}

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
