kuellenberg/DP83848C-EvalBoard/Firmware-DP83848C-Evalboard/Firmware-DP83848C-Evalboard.ioc

PH0-OSC_IN.Signal=RCC_OSC_IN
Mcu.UserName=STM32F407VGTx
PC4.Signal=ETH_RXD0
PD0.GPIO_Label=LED
PB11.Signal=ETH_TX_EN
PB13.Signal=ETH_TXD1
PA13.Signal=SYS_JTMS-SWDIO
PA12.Signal=USB_OTG_FS_DP
PD0.Signal=GPIO_Output
PA1.Signal=ETH_REF_CLK
PH1-OSC_OUT.Signal=RCC_OSC_OUT
PA2.Signal=ETH_MDIO
PA11.Signal=USB_OTG_FS_DM
PA14.Signal=SYS_JTCK-SWCLK
PC5.Signal=ETH_RXD1
PC1.Signal=ETH_MDC
PB12.Signal=ETH_TXD0
PA7.Signal=ETH_CRS_DV
