kuellenberg/DP83848C-EvalBoard/(commit log)

2020-12-18 Work in progress
    [DP83848C-EvalBoard.kicad_pcb, DP83848C-EvalBoard.sch, MCU.sch, PHY.sch, PSU.sch, USB.sch]
2020-12-19 Component placement
    [DP83848C-EvalBoard.sch, MCU.sch, PHY.sch, PSU.sch, USB.sch]
2020-12-24 Added ESD protection
    [DP83848C-EvalBoard.kicad_pcb, DP83848C-EvalBoard.sch, IO.sch, MCU.sch, PHY.sch, PSU.sch]
2021-01-06 DRC and minor changes
    [DP83848C-EvalBoard.kicad_pcb, DP83848C-EvalBoard.sch, IO.sch, MCU.sch, PHY.sch, PSU.sch]
2021-01-07 Revert "Text"
    This reverts commit 08ad5a624c52bb92dd714530982a715c3c379f2a.
    [DP83848C-EvalBoard.kicad_pcb]
2021-01-07 Minor changes
    [DP83848C-EvalBoard-B_Cu.gbr, DP83848C-EvalBoard-B_Mask.gbr, DP83848C-EvalBoard-B_Paste.gbr, DP83848C-EvalBoard-B_SilkS.gbr, DP83848C-EvalBoard-Edge_Cuts.gbr, DP83848C-EvalBoard-F_Cu.gbr, DP83848C-EvalBoard-F_Mask.gbr, DP83848C-EvalBoard-F_Paste.gbr]
2021-02-22 Minor changes and production files
    [DP83848C-EvalBoard-B_Cu.gbr, DP83848C-EvalBoard-B_Mask.gbr, DP83848C-EvalBoard-B_Paste.gbr, DP83848C-EvalBoard-B_SilkS.gbr, DP83848C-EvalBoard-Edge_Cuts.gbr, DP83848C-EvalBoard-F_Cu.gbr, DP83848C-EvalBoard-F_Mask.gbr, DP83848C-EvalBoard-F_Paste.gbr]
